Dr-CK/ElectronicLoad/Electronic load photo.jpg

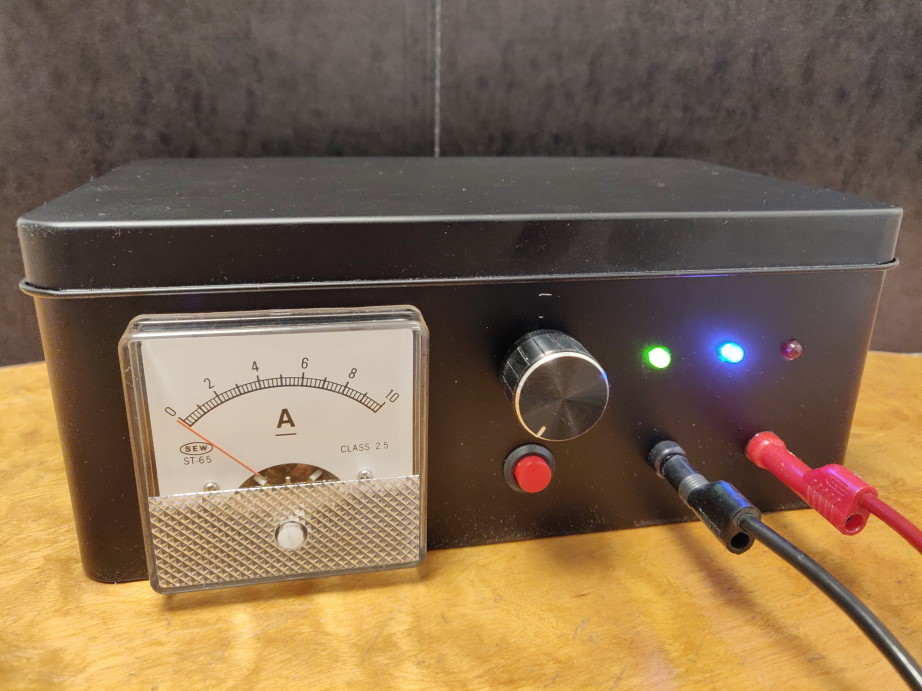
Electronic load photo.jpg
