Dr-CK/ElectronicLoad/Test of home made power supply.jpg

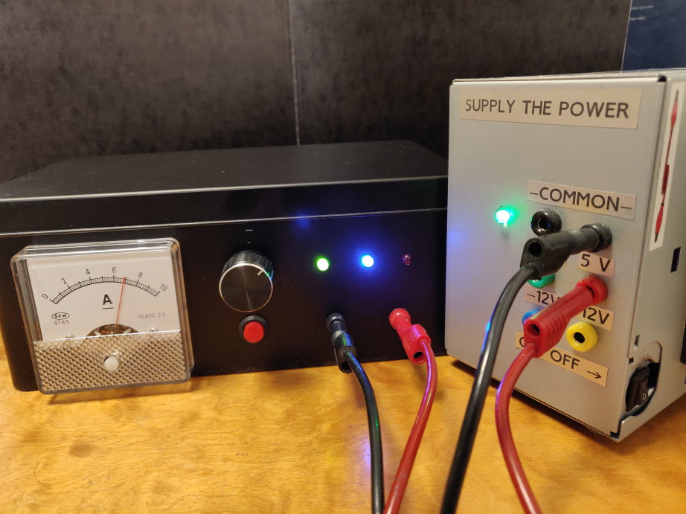
Test of home made power supply.jpg
