Dr-CK/ElectronicLoad/README.md

# ElectronicLoad
 A 10A-200VDC variable electronic load
